Henry7090/QUAD_CORE_AQUILA/sw/rtos_cnn/ocr/debug.txt

weights

#ifdef DEBUG
    uint8_t in_weights[152696] = {3, 0, 0, 0, 16, 3, 0, 0, 48, 0, 0, 0, 10, 0, 0, 0, 216, 233, 73, 188, 49, 31, 112, 188, 22, 105, 96, 188, 91, 24, 53, 188, 46, 68, 18, 188, 140, 6, 10, 188, 125, 122, 31, 188, 217, 34, 81, 188, 251, 45, 139, 188, 177, 80, 168, 188, 167, 192, 198, 188, 81, 108, 231, 188, 68, 123, 1, 189, 157, 90, 13, 189, 99, 152, 21, 189, 189, 68, 26, 189, 73, 250, 25, 189, 106, 93, 22, 189, 4, 204, 13, 189, 154, 77, 245, 188, 251, 250, 176, 188, 90, 75, 2, 188, 89, 205, 26, 60, 155, 36, 207, 60, 2, 192, 20, 61, 237, 126, 45, 61, 89, 1, 66, 61, 194, 42, 73, 61, 211, 204, 148, 188, 105, 77, 152, 188, 143, 112, 140, 188, 5, 249, 114, 188, 211, 100, 93, 188, 66, 206, 111, 188, 16, 41, 144, 188, 216, 237, 175, 188, 98, 94, 213, 188, 76, 129, 247, 188, 167, 143, 9, 189, 67, 133, 20, 189, 217, 119, 28, 189, 81, 156, 33, 189, 2, 102, 36, 189, 62, 187, 35, 189, 146, 23, 32, 189, 98, 186, 23, 189, 223, 35, 11, 189, 89, 140, 233, 188, 159, 88, 159, 188, 169, 176, 208, 187, 194, 121, 253, 59, 250, 16, 154, 60, 75, 57, 215, 60, 178, 236, 255, 60, 50, 22, 19, 61, 180, 84, 26, 61, 170, 95, 148, 188, 154, 5, 142, 188, 80, 219, 123, 188, 102, 90, 93, 188, 245, 227, 85, 188, 53, 4, 123, 188, 37, 248, 158, 188, 177, 29, 197, 188, 89, 209, 234, 188, 121, 136, 5, 189, 184, 82, 17, 189, 5, 26, 25, 189, 152, 219, 29, 189, 128, 16, 31, 189, 153, 245, 29, 189, 54, 244, 25, 189, 95, 42, 18, 189, 183, 132, 4, 189, 246, 132, 228, 188, 153, 229, 172, 188, 245, 207, 65, 188, 41, 145, 170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
