Henry7090/QUAD_CORE_AQUILA/(commit log)

2024-10-09 first push
    [waveform.csv]
2024-11-03 change boot code
    [waveform.csv]
2024-11-03 add uartboot
2025-10-06 change to the new hw, and add RTOS in sw
    [waveform.csv]
